ArthurSabadini/eecs2032-braille-writer/Reports/system_report.pdf

# EECS 2032 Finale Project Report: Braille Writer Project

### Arthur Sabadini Nascimento, Student Number: 220007175

### April 18, 2024

1

## Contents

1 Section 1 | 3
2 Section 2 | 5
3 Section 3 | 13

3.4 Can this project be continued and result in a marketable prod-

References | 15

All design files and proposal reports can be found in this (https://github.com/ArthurSabadini/eecs2032-braille-writer) GitHub directory (https://github.com/ArthurSabadini/eecs2032-braille-writer), and the demonstration video can be found here. (https://www.youtube.com/watch?v=A-jqoaMqUTU)

(https://www.youtube.com/watch?v=A-jqoaMqUTU)

2

## Section 1

### Abstract

Our project consists of a Braille writer for people with vision impairment. This embedded system gets text input through an infrared module and translates the English text data into the American Braille language using solenoids as actuators.

Three pairs of such actuators will be used to lift pins up and down, to mimic the braille language, to provide accessibility for people with vision impairments, and to enable them to read data, as other people can.

### Roles

- Arthur Sabadini Nascimento

– Circuitry Design

Design the circuitry. Develop drivers for the six solenoids, and overall inputs/outputs to the Arduino and other devices. These solenoids should be controllable from the Actuator control unit.

– Infrared Communication Development

Develop a system that can recognize a series of inputs from an infrared device and encode those signals into a data format that the translation software can understand.

- Syed Mustafa Jamal

– Translation Software Development

Working on the translation software side, used to translate braille to english and vice versa. There would be other parts of the code, for example, communicating with a display or speaker if added.

– Actuators Control Unit Development

Implement actuator control for the purpose of making sure they respond correctly to intended output that is safe and secure in the form factor we hope to achieve.

3

– Testing

Run tests on the software and its compatibility with the hardware. It can also be done with others to see if people who are blind or can benefit from it would like it.

### Expected Results

We expect to be able to send a message to the Arduino through an infrared device, then, in software, translate English messages into the American Braille language. It will do so by sending signals to 6 solenoids, which will lift up or down to signify the bumps of the American braille language.

4

## Section 2

### Board Selection

The Arduino Mega board was selected, since it has more memory than the Uno (256KB), enough to support all the software. It also has more than enough pins (16 analog pins and 53 digital pins), and we were able to connect all required devices.

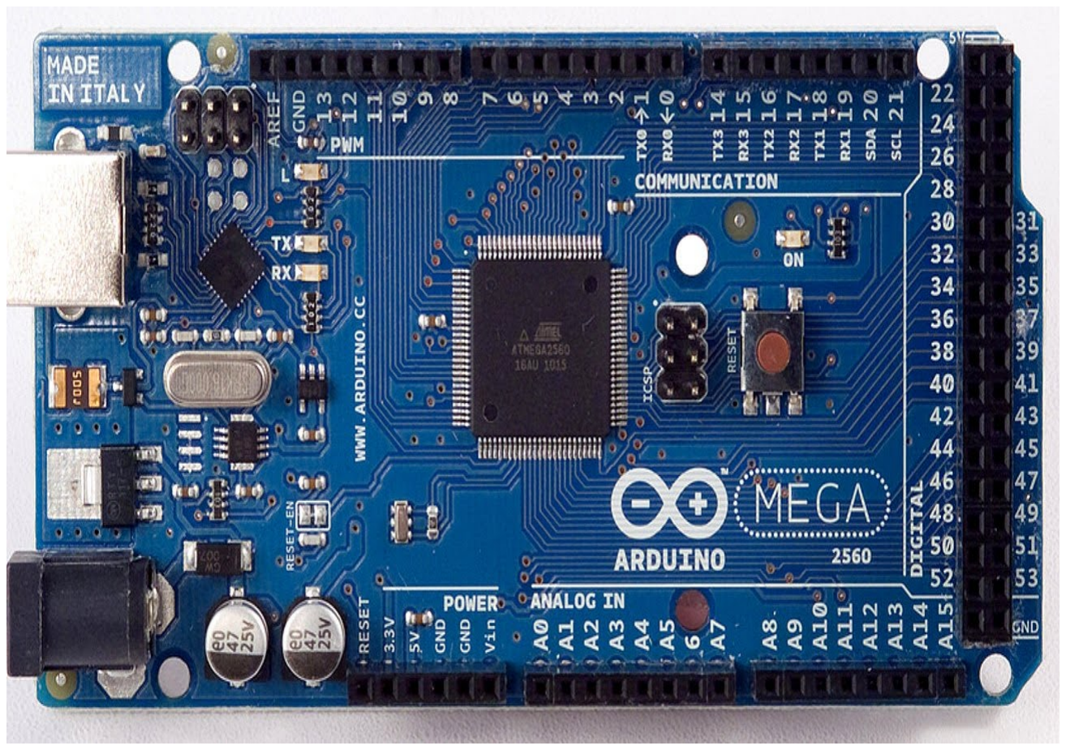
[picture p10: figure]

Figure 1: Arduino Mega [3]

5

### Solenoid Driver

Driver Design

The circuit below was the chosen design for the solenoid driver. The MOS-FET is used for switching the solenoid on and off, and the diode is for flyback protection

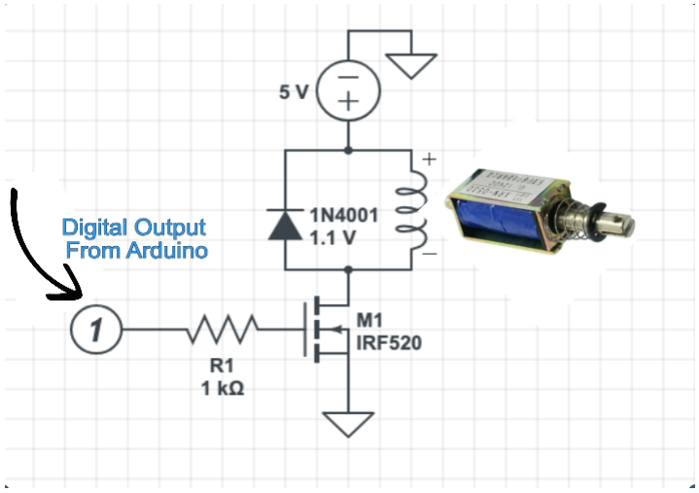
[picture p11: figure]

Figure 2: Solenoid Driver Circuit

6

Implemented Driver

The circuit below is the implementation of the driver described above. This driver circuit was constructed 5 more times (6 in total) to control all 6 solenoids.


Figure 3: Implemented Driver

7

### Final Circuitry Design

Full Design Schematic


Figure 4: Full Schematic

8

Implemented Circuitry

The circuit below is the implementation of the full circuitry. In orange, all 6 solenoid drivers. In pink, the shift register used to control all solenoid drivers. In red, the infrared sensor, used to get input from a remote control.


Figure 5: Implemented Circuit

9

### InfraRed Decoder Library

I developed an Arduino library that was able to receive inputs from an infrared controller in an ordered way, and organize the input into a useful datatype to be used in the code to actuate the solenoids.

The IRdecoder (source [1]) library was coded in C++ and used the simplified Arduino standard library for its implementation, as well as the IRremote (source [2]) library.

To collect input from a remote control, we used an interrupt function that gets activated whenever the infrared module receives an input, to optimize input responsiveness.

The ISR is called whenever the infrared receiver receives an input. It reads the received signal and decodes it. If ’NEXT WORD’ is pressed, we save the current symbol to the buffer and wait for the next one. If ’DELETE WORD’ is pressed, we remove the symbol from the buffer. If ’CONCLUDE’ is pressed, we save the buffer and resume input acquisition, otherwise, the current symbol is updated in the buffer.

147 | void IRdecoder :: inputInterruptHandler () {
148 | volatile uint32_t buttonPressed = readSignal () ;
149 | if( buttonPressed == UNDEFINED ) return ;

150
151 | switch ( buttonPressed ) {
152 | case IRdecoder :: NEXT_WORD :
153 | // Add next word to symbols list
154 | input_buffer . add ( symbol );
155 | resetState () ;
156 | break ;
157 | case IRdecoder :: DELETE_WORD :
158 | // Delete current word
159 | if (! input_buffer . empty () ) input_buffer . pop_back () ;
160 | resetState () ;
161 | break ;
162 | case IRdecoder :: CONCLUDE :
163 | // Complete input , save and exit
164 | resetState () ;
165 | endReceiveInput () ;
166 | break ;
167 | default :
168 | updateCurrentSymbol () ;
169 | break ;
170 | }
171 | }
Listing 1: IRdecoder Interrupt Service Routine

10

Library Implementation

Below you can see the header file of the object used to decode the infrared signals.

165 | // Main class definition
166 | class IRdecoder {
167 | public :
168 | BufferIO <3 , 2> input_buffer ;
169 | bool isInInputMode = false ;

170
171 | // Buttons defined for I/O f un ct io na li ty
172 | const static uint32_t NEXT_WORD = FAST_FORWARD ;
173 | const static uint32_t DELETE_WORD = REWIND ;
174 | const static uint32_t CONCLUDE = POWER ;

175
176 | IRdecoder ( uint8_t pin ) : pin ( pin ) , input_buffer ( BUFFER_SIZE ) ,
| irrec ( pin ) , results () {};

177
178 | void setup () ;
179 | void beginReceiveInput () ;
180 | void resetState () ;
181 | String getStringfiedState () ;
182 | String getStringfiedSymbol () ;

183
184 | static void ISRHandler () {
185 | if (! currentInstance ) return ;
186 | currentInstance -> inputInterruptHandler () ;
187 | }

188
189 | private :
190 | static IRdecoder * currentInstance ;
191 | bool wasInitialized = false ;
192 | bool isActive = false ;

193
194 | uint8_t pin ;
195 | uint8_t control_state [ ROWS ][ COLS ]{};
196 | uint8_t symbol [3][2]{};

197
198 | IRrecv irrec ;
199 | decode_results results ;

200
201 | void endReceiveInput () ;
202 | volatile uint32_t readSignal () ; // volatile used , since input could
| change

203
204 | void updateCurrentSymbol () ;
205 | uint32_t indexToButtonVal ( uint8_t index1 , uint8_t index2 );
206 | uint8_t * buttonValToIndex ( uint32_t buttonVal ); // Don ’t forget to
| free memory when not needed
207 | void inputInterruptHandler () ;
208 | };

209
210 # endif
Listing 2: IRdecoder Definitions

11

Macros Definition

When a button is pressed on the RC control, a specific signal is sent to the receiver, which we can use to identify which button has been pressed to collect inputs. Below, you can see the macro definitions for the infrared signal emitted from every button in the remote control.

1 | // Config Definitions
2 | # define ACTION_WINDON_MS 250
3 | # define ACTION_WINDOW_US 250000
4 | # define BUFFER_SIZE 11
5 | # define ROWS 7
6 | # define COLS 3

7
8 | // Remote Buttons Code
9 | # define POWER 0 xFFA25D
10 | # define VOL_PLUS 0 xFF629D
11 | # define FUNC_STOP 0 xFFE21D
12 | # define REWIND 0 xFF22DD
13 | # define PAUSE 0 xFF02FD
14 | # define FAST_FORWARD 0 xFFC23D
15 | # define DOWN 0 xFFE01F
16 | # define VOL_MINUS 0 xFFA857
17 | # define UP 0 xFF906F
18 | # define ZERO 0 xFF6897
19 | # define EQ 0 xFF9867
20 | # define ST_REPT 0 xFFB04F
21 | # define ONE 0 xFF30CF
22 | # define TWO 0 xFF18E7
23 | # define THREE 0 xFF7A85
24 | # define FOUR 0 xFF10EF
25 | # define FIVE 0 xFF38C7
26 | # define SIX 0 xFF5AA5
27 | # define SEVEN 0 xFF42BD
28 | # define EIGHT 0 xFF4AB5
29 | # define NINE 0 xFF52AD
30 | # define UNDEFINED 0 xFFFFFF
Listing 3: Macros

12

## Section 3

### How has my Role benefited from the course 2210?

My role in this project, as the hardware designer, has benefited quite a lot from the course 2210.

The designed driver uses components such as MOSFETs and diodes, components that we learned in depth about in the course. Without such components, I wouldn’t be able to design the driver, since MOSFETs are usually used for rapid switching with microcontroller applications.

### What problems were solved?

We could not just control the solenoids directly from the Arduino pins; the Arduino can’t provide enough current to actuate the solenoids. To fix this, I designed a solenoid driver that can be used to safely control each solenoid from the Arduino.

If the solenoids were kept on for too long, that could cause the MOSFETs to heat up too much. Testing showed that an “on” period of 500ms was enough to be detected, and to minimize stresses, we turned the solenoids off for 250 ms after it was actuated.

To minimize power consumption, we decided to flip the solenoids upside down. Since in braille, there are more flats than bumps, fewer solenoids would be actuated.

### What has been learned?

I learned how to design motor drivers, which was quite exciting! And I also learned how to best select a microcontroller for a given project, depending on the hardware needs

I also learned how to read datasheets, since I had to do that a lot to check each component’s parameters and limits.

13

### Can this project be continued and result in a marketable product?

Yes! There is a great need in the space of accessibility in technology. In the market, there are tons of projects that convert braille to English, but none that do the opposite, as our project does

In conclusion, our project would improve accessibility for people with vision impairments, and there’s also a need for it in the market. So indeed it could result in a marketable product!

### How successful was the project in achieving its goals?

The project was very successful, we were able to achieve all expected results. I designed a driver to easily and safely control all 6 solenoids from a microcontroller, and we were able to translate an English-text infrared input into braille, and actuate the solenoids accordingly to represent the braille language and output a simple message.

14

## References

[1] arthur-sabadini-nascimento. ArthurSabadini/eecs2032-braille-writer. original-date: 2024-03-08T01:46:53Z. Apr. 17, 2024. url: https://github.com/ArthurSabadini/eecs2032-braille-writer (https://github.com/ArthurSabadini/eecs2032-braille-writer) (visited on 04/26/2025).
[2] Arduino-IRremote/Arduino-IRremote. original-date: 2010-01-23T04:37:22Z. Apr. 26, 2025. url: https://github.com/Arduino-IRremote/Arduino-IRremote (https://github.com/Arduino-IRremote/Arduino-IRremote) (visited on 04/26/2025).
[3] Mega 2560 Rev3 — Arduino Documentation. url: https : / / docs . arduino.cc/hardware/mega-2560/ (https://docs.arduino.cc/hardware/mega-2560/) (visited on 04/26/2025).

15
