ArthurSabadini/eecs2032-braille-writer/Reports/braille-writter-schematic.pdf

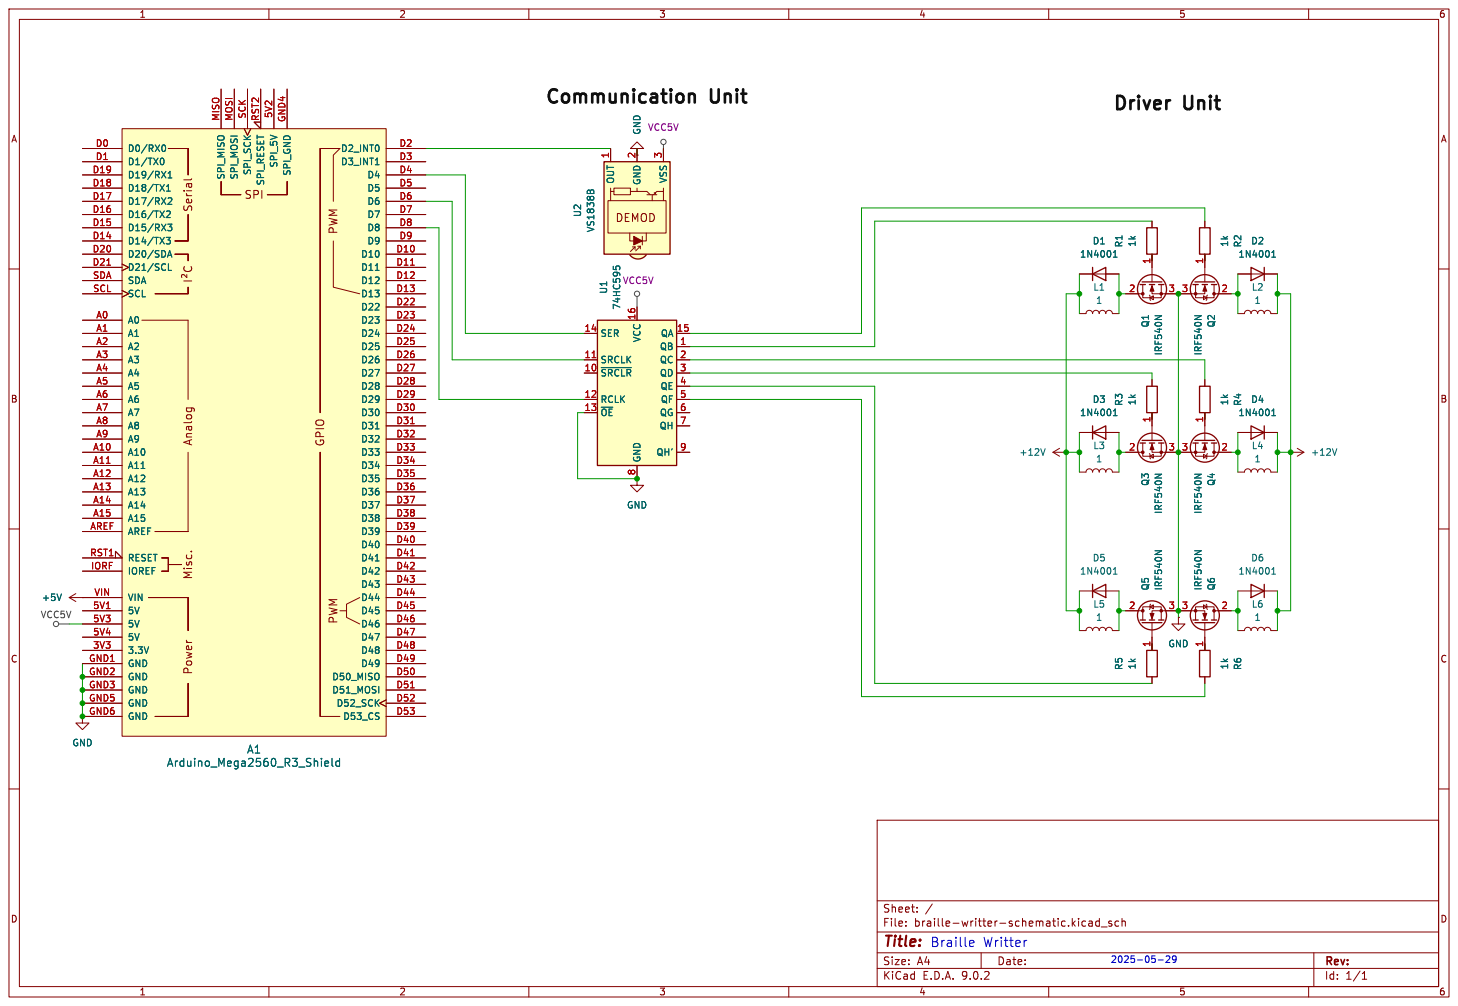
[picture p12: page 1]
