ArthurSabadini/eecs2032-braille-writer/(commit log)

2024-03-12 Input System Interrupt Implementation
2024-04-01 Translation Code renamed + Corrections
    [examples.ino, tests.ino, translation.ino]
2024-04-02 BufferIO pop_back() and pop_front() bug fixes
    [IRdecoder.cpp, IRdecoder.h, converter.h, translation.ino]
2025-05-29 Update utils.h
    Switching the Clock and Latch pins of the shift register 74H595.
2025-05-29 Adding Circuitry Schematic
