ArthurSabadini/eecs2032-braille-writer/(notices)

Notices in the files:
README.md:
License:
[MIT License](https://choosealicense.com/licenses/mit/)
